jakubprzybytek/DCCoverter/KiCad/LM5175-DCConverter/LM5175-DCConverter.kicad_pcb

## KiCad design KiCad/LM5175-DCConverter/LM5175-DCConverter.kicad_pcb (2020-11-04)

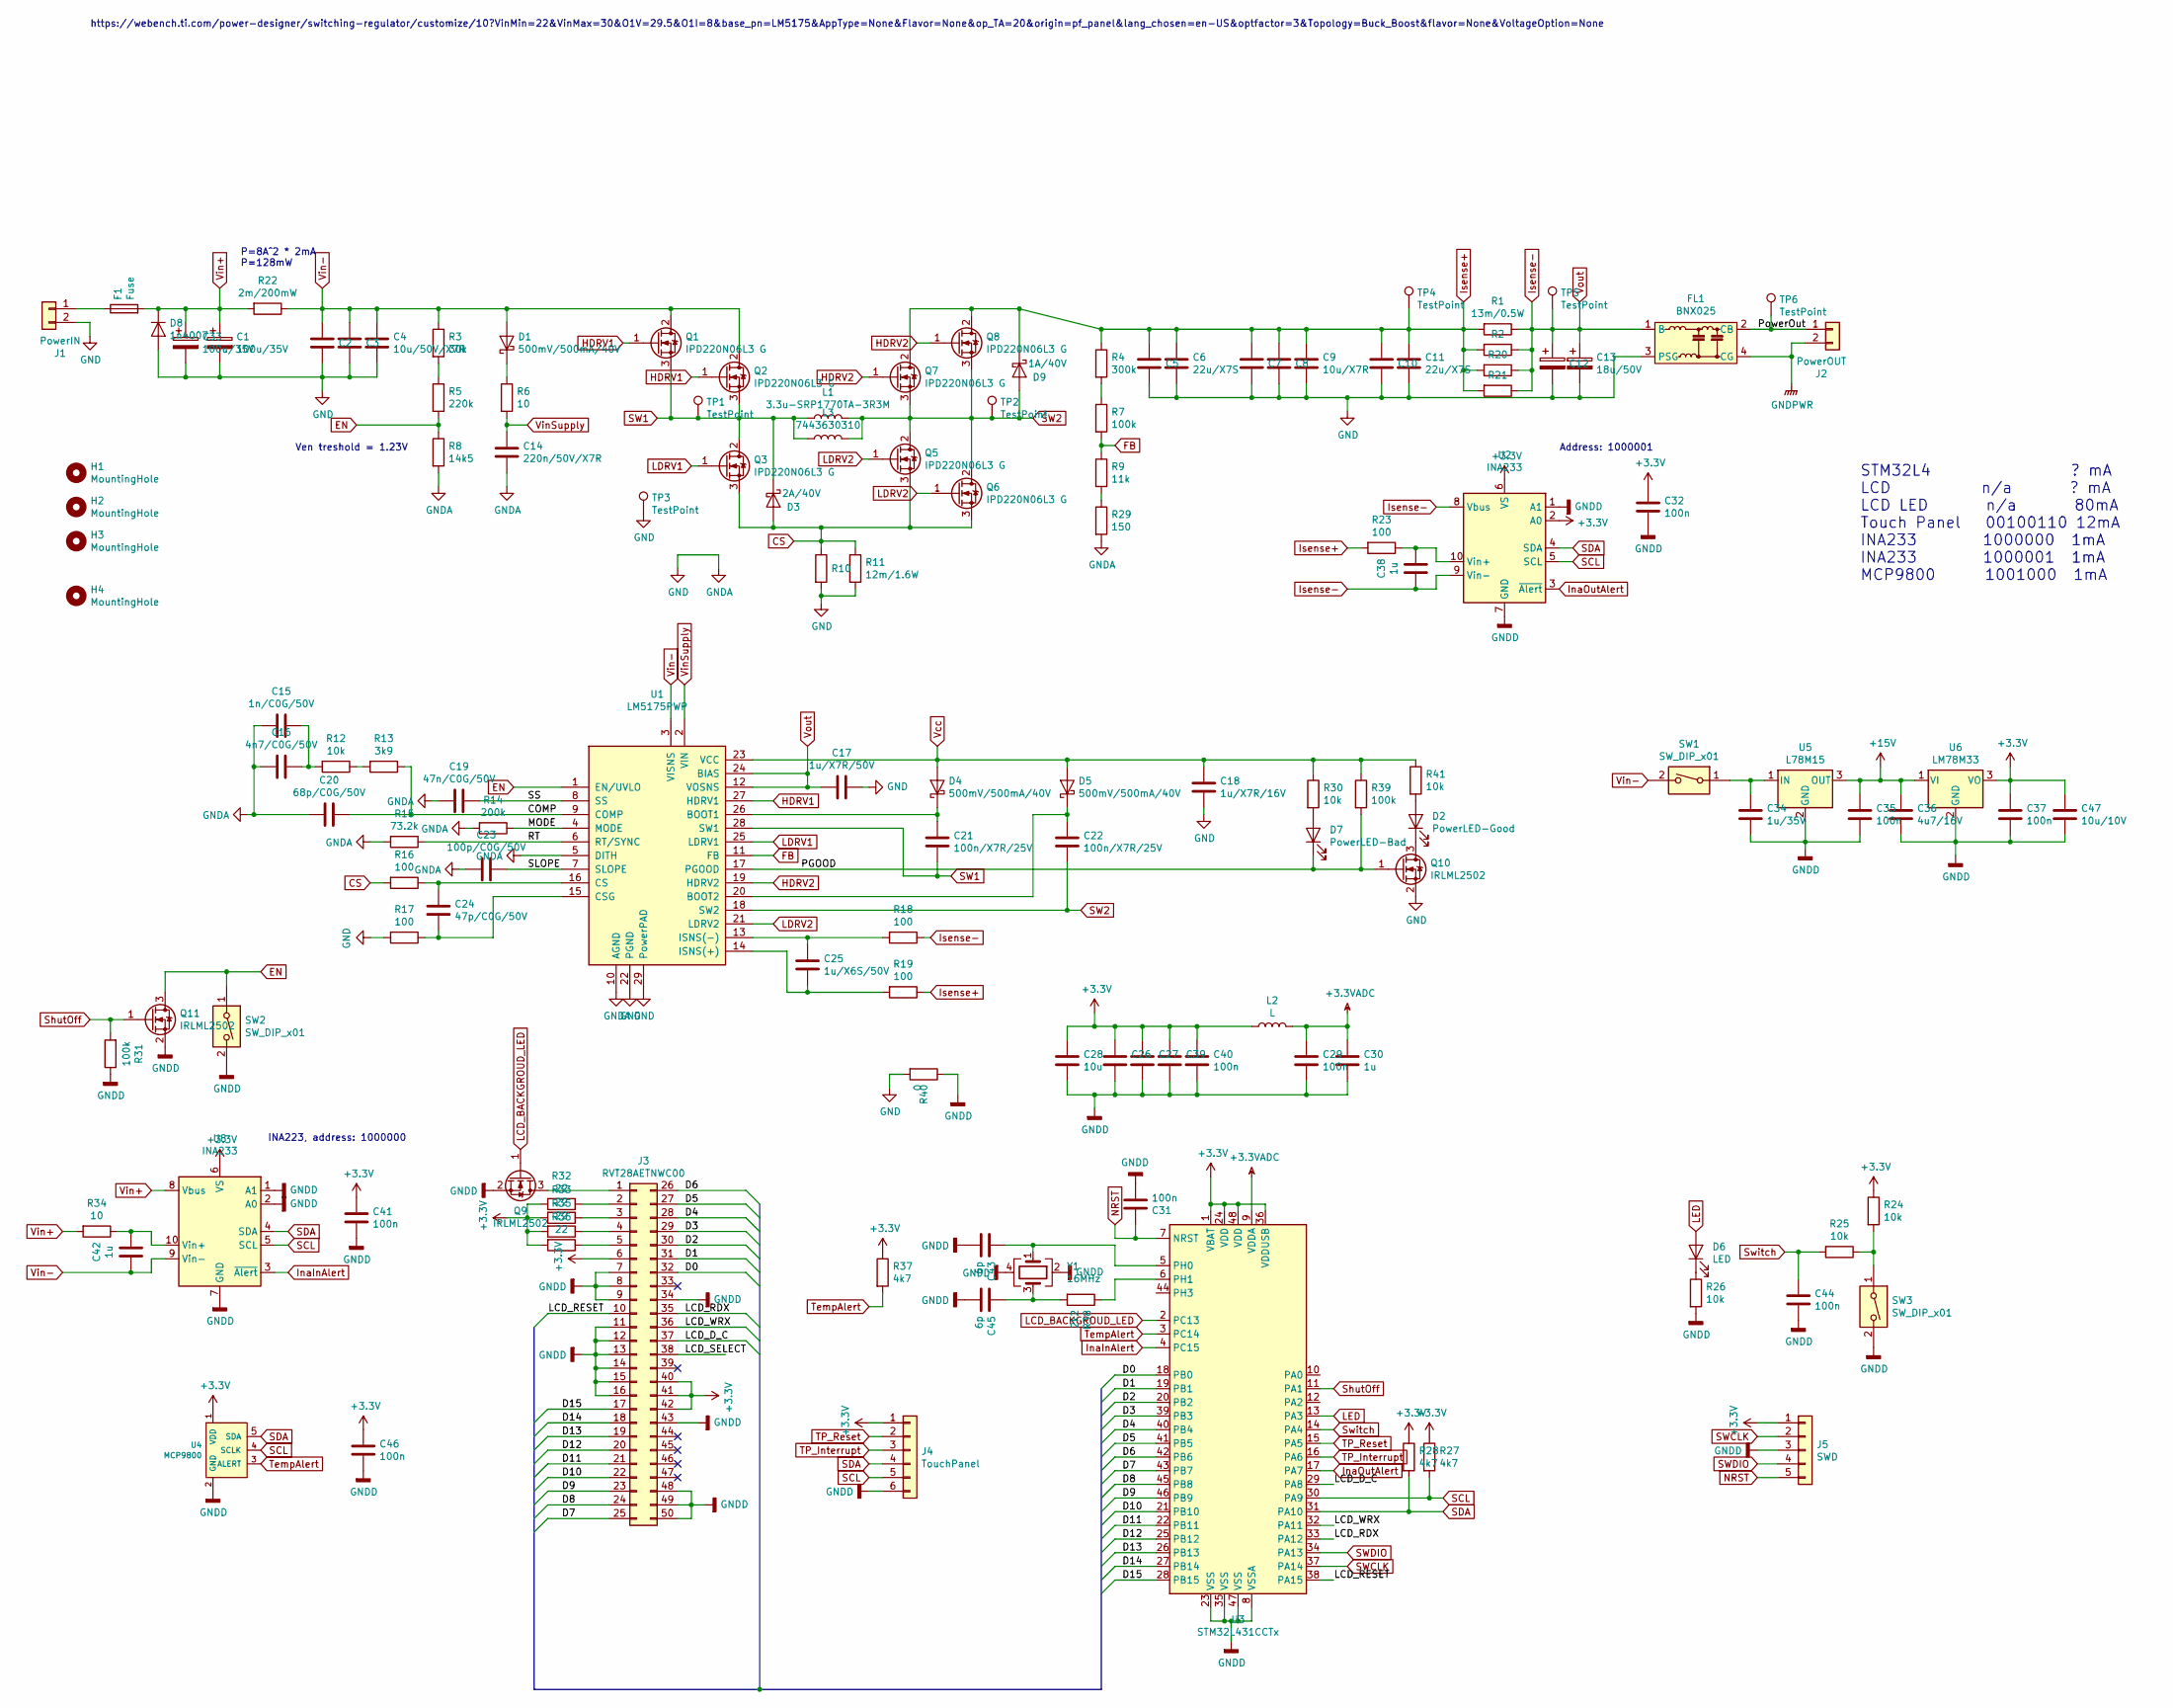
[picture p1: schematic LM5175-DCConverter.sch]

Parts:
C1, C33: 100u/35V; C_Elec_8x6.2
C2, C3, C4: 10u/50V/X7R; C_1210_3225Metric
C5, C6, C10, C11: 22u/X7S; C_2220_5650Metric
C7, C8, C9: 10u/X7R; C_2220_5650Metric
C12, C13: 18u/50V; C_Elec_6.3x5.8
C14: 220n/50V/X7R; C_0805_2012Metric
C15: 1n/C0G/50V; C_0805_2012Metric
C16: 4n7/C0G/50V; C_0805_2012Metric
C17: 1u/X7R/50V; C_0805_2012Metric
C18: 1u/X7R/16V; C_0805_2012Metric
C19: 47n/C0G/50V; C_0805_2012Metric
C20: 68p/C0G/50V; C_0805_2012Metric
C21, C22: 100n/X7R/25V; C_0805_2012Metric
C23: 100p/C0G/50V; C_0805_2012Metric
C24: 47p/C0G/50V; C_0805_2012Metric
C25: 1u/X6S/50V; C_0805_2012Metric
C26, C27, C29, C31, C32, C35, C37, C39, C40, C41, C44, C46: 100n; C_0603_1608Metric
C28: 10u; C_0805_2012Metric
C30, C38, C42: 1u; C_0805_2012Metric
C34: 1u/35V; C_1206_3216Metric
C36: 4u7/16V; C_1206_3216Metric
C43, C45: 6p; C_0805_2012Metric
C47: 10u/10V; C_1206_3216Metric
D1, D4, D5: 500mV/500mA/40V; D_SMA
D2: PowerLED-Good; LED_0805_2012Metric
D3: 2A/40V; D_SMB
D6: LED; LED_0805_2012Metric
D7: PowerLED-Bad; LED_0805_2012Metric
D8: 1n4007; D_MELF
D9: 1A/40V; D_SMB
F1: Fuse; Fuseholder5x20_horiz_open_big
FL1: BNX025; Filter_Murata_BNX005
H1, H2, H3, H4: MountingHole; MountingHole_3.2mm_M3
J1: PowerIN; XT60PW-M
J2: PowerOUT; XT60PW-M
J3: RVT28AETNWC00; Hirose_FH12-50S-0.5SH_1x50-1MP_P0.50mm_Horizontal
J4: TouchPanel; TE_0-1734839-6_1x06-1MP_P0.5mm_Horizontal
J5: SWD; PinHeader_1x05_P2.54mm_Horizontal
L1: 3.3u-SRP1770TA-3R3M; L_Bourns_SRP1770TA
L2: L; L_0805_2012Metric
L3: 7443630310; L_Wuerth_WE-HCF
Q1, Q2, Q3, Q5, Q6, Q7, Q8: IPD220N06L3 G; TO-252-2
Q9, Q10, Q11: IRLML2502; SOT-23
R1, R2, R20, R21: 13m/0.5W; R_1206_3216Metric
R3: 30k; R_0805_2012Metric
R4: 300k; R_0805_2012Metric
R5: 220k; R_0805_2012Metric
R6: 10; R_1206_3216Metric
R7, R31, R39: 100k; R_0805_2012Metric
R8: 14k5; R_0805_2012Metric
R9: 11k; R_0805_2012Metric
R10, R11: 12m/1.6W; R_2512_6332Metric
R12, R26, R30, R41: 10k; R_0805_2012Metric
R13: 3k9; R_0805_2012Metric
R14: 200k; R_0805_2012Metric
R15: 73.2k; R_0805_2012Metric
R16, R17, R18, R19, R23: 100; R_0805_2012Metric
R22: 2m/200mW; R_2512_6332Metric
R24, R25: 10k; R_0603_1608Metric
R27, R28, R37: 4k7; R_0805_2012Metric
R29: 150; R_0805_2012Metric
R32, R33, R35, R36: 22; R_0805_2012Metric
R34: 10; R_0805_2012Metric
R38: 2k2; R_0805_2012Metric
R40: 0; SolderJumper-2_P1.3mm_Bridged2Bar_Pad1.0x1.5mm
SW1, SW2: SW_DIP_x01; JST_PH_S2B-PH-K_1x02_P2.00mm_Horizontal
SW3: SW_DIP_x01; SW_SPST_B3S-1000
TP1, TP2, TP3, TP4, TP5, TP6: TestPoint; TestPoint_THTPad_D1.0mm_Drill0.5mm
U1: LM5175PWP; HTSSOP-28-1EP_4.4x9.7mm_P0.65mm_EP3.4x9.5mm_ThermalVias
U2, U8: INA233; VSSOP-10_3x3mm_P0.5mm
U3: STM32L431CCTx; LQFP-48_7x7mm_P0.5mm
U4: MCP9800; SOT-23-5
U5: L78M15; TO-252-2
U6: LM78M33; TO-252-2
Y1: 16MHz; Crystal_SMD_Abracon_ABM3B-4Pin_5.0x3.2mm

Connections:
+3.3VADC: C29.1, C30.1, L2.2, U3.9 (VDDA)
+3V3: C26.1, C27.1, C28.1, C32.1, C37.1, C39.1, C40.1, C41.1, C46.1, C47.1, J3.6, J3.40, J3.41, J3.42, J4.1, J5.1, L2.1, R24.1, R27.1, R28.1, R32.2, R33.2, R35.2, R36.2, R37.1, U2.2 (A0), U2.6 (VS), U3.1 (VBAT), U3.24 (VDD), U3.36 (VDDUSB), U3.48 (VDD), U4.1 (VDD), U6.3 (VO), U8.6 (VS)
+15V: C35.1, C36.1, U5.3 (OUT), U6.1 (VI)
/COMP: C20.2, R13.1, U1.9 (COMP)
/D0: J3.32, U3.18 (PB0)
/D1: J3.31, U3.19 (PB1)
/D2: J3.30, U3.20 (PB2)
/D3: J3.29, U3.39 (PB3)
/D4: J3.28, U3.40 (PB4)
/D5: J3.27, U3.41 (PB5)
/D6: J3.26, U3.42 (PB6)
/D7: J3.25, U3.43 (PB7)
/D8: J3.24, U3.45 (PB8)
/D9: J3.23, U3.46 (PB9)
/D10: J3.22, U3.21 (PB10)
/D11: J3.21, U3.22 (PB11)
/D12: J3.20, U3.25 (PB12)
/D13: J3.19, U3.26 (PB13)
/D14: J3.18, U3.27 (PB14)
/D15: J3.17, U3.28 (PB15)
/LCD_D_C: J3.37, U3.29 (PA8)
/LCD_RDX: J3.35, U3.33 (PA12)
/LCD_RESET: J3.10, U3.38 (PA15)
/LCD_SELECT: J3.38
/LCD_WRX: J3.36, U3.32 (PA11)
/MODE: R14.1, U1.4 (MODE)
/PGOOD: D7.1 (K), Q10.1 (G), R39.2, U1.17 (PGOOD)
/PowerOut: FL1.2 (CB), J2.1, TP6.1
/RT: R15.1, U1.6 (RT/SYNC)
/SLOPE: C23.2, U1.7 (SLOPE)
/SS: C19.2, U1.8 (SS)
CS: D3.2 (A), Q3.3 (S), Q5.3 (S), Q6.3 (S), R10.1, R11.1, R16.2
EN: Q11.3 (D), R5.2, R8.1, SW2.1, U1.1 (EN/UVLO)
FB: R7.2, R9.1, U1.11 (FB)
GND: C1.2, C2.2, C3.2, C4.2, C5.2, C6.2, C7.2, C8.2, C9.2, C10.2, C11.2, C12.2, C13.2, C14.2, C15.1, C16.1, C17.1, C18.2, C19.1, C20.1, C23.1, C33.2, D8.2 (A), FL1.3 (PSG), J1.2, Q10.2 (S), R8.2, R10.2, R11.2, R14.2, R15.2, R17.2, R29.2, R40.2, TP3.1, U1.5 (DITH), U1.10 (AGND), U1.22 (PGND), U1.29 (PowerPAD)
GNDD: C26.2, C27.2, C28.2, C29.2, C30.2, C31.2, C32.2, C34.2, C35.2, C36.2, C37.2, C39.2, C40.2, C41.2, C43.2, C44.2, C45.2, C46.2, C47.2, J3.7, J3.8, J3.9, J3.11, J3.12, J3.13, J3.14, J3.15, J3.16, J3.34, J3.43, J3.48, J3.49, J3.50, J4.6, J5.3, Q9.2 (S), Q11.2 (S), R26.2, R31.1, R40.1, SW2.2, SW3.2, U2.1 (A1), U2.7 (GND), U3.8 (VSSA), U3.23 (VSS), U3.35 (VSS), U3.47 (VSS), U4.2 (GND), U5.2 (GND), U6.2 (GND), U8.1 (A1), U8.2 (A0), U8.7 (GND), Y1.2, Y1.4
GNDPWR: FL1.4 (CG), J2.2
HDRV1: Q1.1 (G), Q2.1 (G), U1.27 (HDRV1)
HDRV2: Q7.1 (G), Q8.1 (G), U1.19 (HDRV2)
InaInAlert: U3.4 (PC15), U8.3 (~Alert~)
InaOutAlert: U2.3 (~Alert~), U3.17 (PA7)
Isense+: C5.1, C6.1, C7.1, C8.1, C9.1, C10.1, C11.1, D9.1 (K), Q7.2 (D), Q8.2 (D), R1.2, R2.2, R4.1, R19.1, R20.2, R21.2, R23.2, TP4.1
Isense-: C12.1, C13.1, C17.2, C38.2, FL1.1 (B), R1.1, R2.1, R18.1, R20.1, R21.1, TP5.1, U1.12 (VOSNS), U1.24 (BIAS), U2.8 (Vbus), U2.9 (Vin-)
LCD_BACKGROUD_LED: Q9.1 (G), U3.2 (PC13)
LDRV1: Q3.1 (G), U1.25 (LDRV1)
LDRV2: Q5.1 (G), Q6.1 (G), U1.21 (LDRV2)
LED: D6.2 (A), U3.13 (PA3)
NRST: C31.1, J5.5, U3.7 (NRST)
unnamed: C15.2, C16.2, R12.2
unnamed: C21.1, D4.1 (K), U1.26 (BOOT1)
unnamed: C22.1, D5.1 (K), U1.20 (BOOT2)
unnamed: C24.1, R16.1, U1.16 (CS)
unnamed: C24.2, R17.1, U1.15 (CSG)
unnamed: C25.1, R18.2, U1.13 (ISNS(-))
unnamed: C25.2, R19.2, U1.14 (ISNS(+))
unnamed: C34.1, SW1.1, U5.1 (IN)
unnamed: C38.1, R23.1, U2.10 (Vin+)
unnamed: C42.1, R34.1, U8.10 (Vin+)
unnamed: C43.1, U3.5 (PH0), Y1.1
unnamed: C45.1, R38.2, Y1.3
unnamed: D1.1 (K), R6.1
unnamed: D2.1 (K), Q10.3 (D)
unnamed: D2.2 (A), R41.2
unnamed: D6.1 (K), R26.1
unnamed: D7.2 (A), R30.2
unnamed: F1.1, J1.1
unnamed: J3.1, Q9.3 (D)
unnamed: J3.2, R32.1
unnamed: J3.3, R33.1
unnamed: J3.4, R35.1
unnamed: J3.5, R36.1
unnamed: R3.2, R5.1
unnamed: R4.2, R7.1
unnamed: R12.1, R13.2
unnamed: R24.2, R25.1, SW3.1
unnamed: R9.2, R29.1
unnamed: R38.1, U3.6 (PH1)
SCL: J4.5, R27.2, U2.5 (SCL), U3.30 (PA9), U4.4 (SCLK), U8.5 (SCL)
SDA: J4.4, R28.2, U2.4 (SDA), U3.31 (PA10), U4.5 (SDA), U8.4 (SDA)
SW1: C21.2, D3.1 (K), L1.1, L3.1, Q1.3 (S), Q2.3 (S), Q3.2 (D), TP1.1, U1.28 (SW1)
SW2: C22.2, D9.2 (A), L1.2, L3.2, Q5.2 (D), Q6.2 (D), Q7.3 (S), Q8.3 (S), TP2.1, U1.18 (SW2)
SWCLK: J5.2, U3.37 (PA14)
SWDIO: J5.4, U3.34 (PA13)
ShutOff: Q11.1 (G), R31.2, U3.11 (PA1)
Switch: C44.1, R25.2, U3.14 (PA4)
TP_Interrupt: J4.3, U3.16 (PA6)
TP_Reset: J4.2, U3.15 (PA5)
TempAlert: R37.2, U3.3 (PC14), U4.3 (ALERT)
Vcc: C18.1, D4.2 (A), D5.2 (A), R30.1, R39.1, R41.1, U1.23 (VCC)
Vin+: C1.1, C33.1, D8.1 (K), F1.2, R22.2, R34.2, U8.8 (Vbus)
Vin-: C2.1, C3.1, C4.1, C42.2, D1.2 (A), Q1.2 (D), Q2.2 (D), R3.1, R22.1, SW1.2, U1.3 (VISNS), U8.9 (Vin-)
VinSupply: C14.1, R6.2, U1.2 (VIN)

Notes on the sheet:
Address: 1000001
STM32L4 ? mA LCD n/a ? mA LCD LED n/a 80mA Touch Panel 00100110 12mA INA233 1000000 1mA INA233 1000001 1mA MCP9800 1001000 1mA
INA223, address: 1000000
https://webench.ti.com/power-designer/switching-regulator/customize/10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
Ven treshold = 1.23V
P=8A^2 * 2mA P=128mW

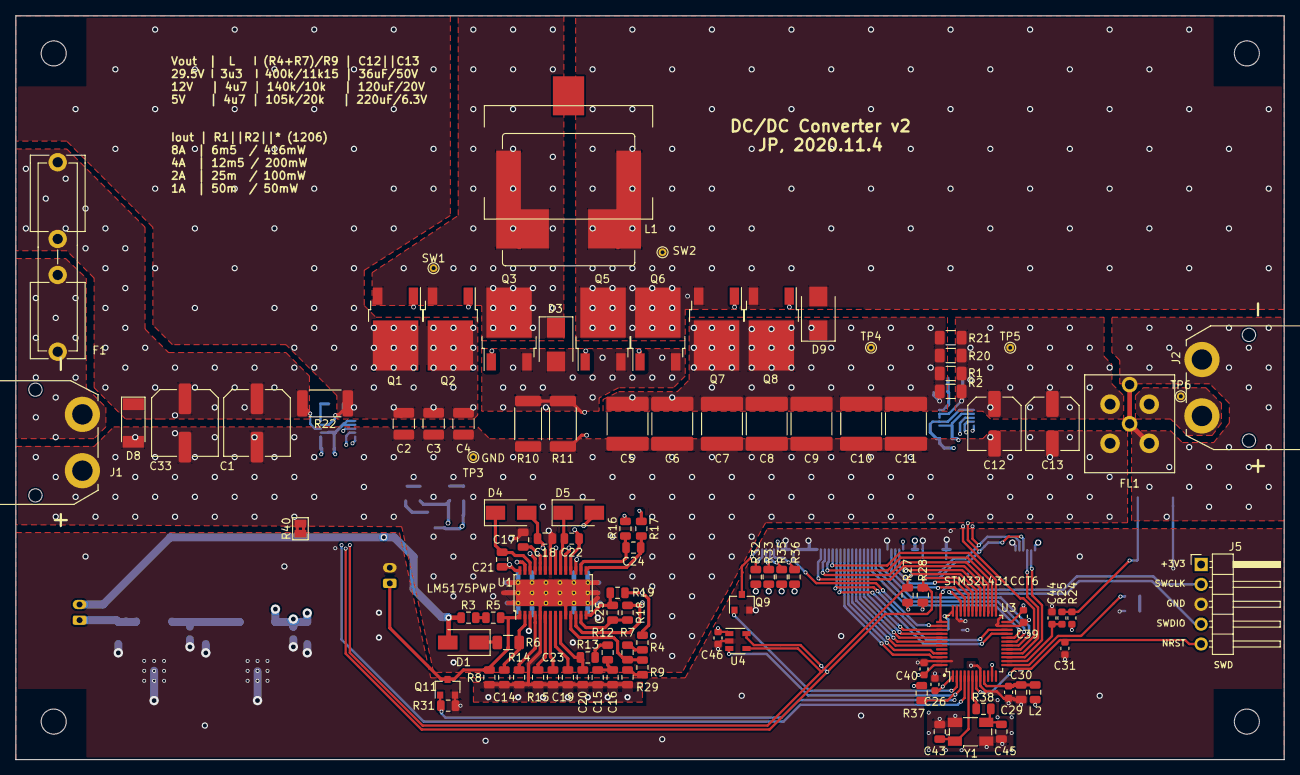
[picture p2: board LM5175-DCConverter.kicad_pcb from above]

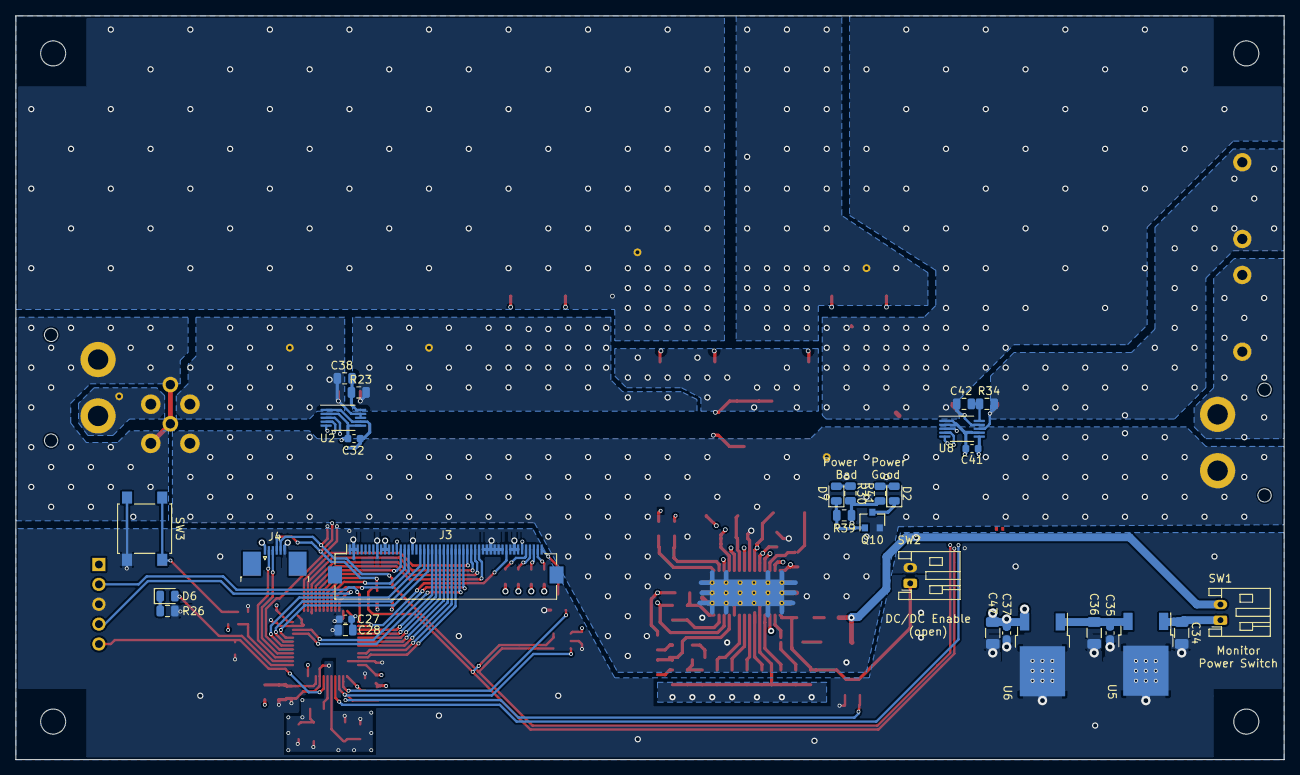
[picture p3: board LM5175-DCConverter.kicad_pcb from below]

Board: 4 copper layers, 162.0 x 95.0 mm, 138 parts (30 on the bottom side), 91 nets.
