jakubprzybytek/DCCoverter/(commit log)

2020-01-30 Init commit
    [LM5175-DCConverter.kicad_pcb, LM5175-DCConverter.sch]
2020-02-02 stm32 added
    [LM5175-DCConverter.kicad_pcb, LM5175-DCConverter.sch]
2020-02-09 MOre PCB work
    [LM5175-DCConverter.kicad_pcb, LM5175-DCConverter.sch]
2020-02-14 Most of the PCB done
    [LM5175-DCConverter.kicad_pcb, LM5175-DCConverter.sch]
2020-07-19 Save before stm32 change
    [LM5175-DCConverter.kicad_pcb, LM5175-DCConverter.sch]
2020-09-28 First fixes after soldering
    [LM5175-DCConverter.kicad_pcb, LM5175-DCConverter.sch]
2020-10-31 Post assembling notes
    [LM5175-DCConverter.kicad_pcb]
2020-11-01 Work on pcb v2
    [LM5175-DCConverter.kicad_pcb, LM5175-DCConverter.sch]
2020-11-04 Last fixes for v2
    [LM5175-DCConverter.kicad_pcb, LM5175-DCConverter.sch]
